cbm-instructions/micro-change/demo_script.md

## Einführung

Stellt euch vor ihr sitzt daheim vor dem Fernseher und seht wieder einmal Bilder von Müllinseln in den Meeren unserer schönen Erde.
Ihr sind bereit euren Beitrag zu leisten und möchtet bewusster und verantwortungsvoller mit eurem Müll umgehen, um genau solche Bilder zu verhindern.
Bei eurem nächsten Einkauf achtet ihr darauf weniger Plastikverpackungen zu kaufen, oder geht vielleicht sogar in einen Verpackungsfreiladen, doch ihr habt nach ein paar Tagen immer noch nicht so wirklich das Gefühl, dass sich etwas an eurem Müllverbrauch geändert hat. Woche für Woche tragt ihr euren Müll raus und fühlt euch machtlos bei dem Kampf um den Schutz unserer Erde.

"Wenn es doch nur eine Möglichkeit gäbe, wie ich meinen Einfluss auf die Umwelt wirklich wahrnehmen könnte!" :(

Sucht nicht länger, denn ihr habt ihn gefunden. Wir präsentieren euch "BEN", den smarten Kumpel für euer Zuhause.
"BEN" hilft euch ganz einfach nachzuvollziehen wie viel Müll ihr Tag für Tag produziert.

Mit seinem integrierten Gewichtssensor misst er wie viel Müll ihr produziert und stellt euch diese Messungen einfach und verständlich dar.
Auf dem hightech Touchdisplay könnt ihr zwischen unterschiedlichen Darstellungsvarianten wählen, um so einen perfekten Einblick in eure eigene Müllproduktion zu erlangen.

Und wenn ihr dachtet das war alles, dann haltet euch fest. Denn die innovativen Köpfe des Teams MicroChange, haben durch ihren modernen Gamefication-Ansatz eine noch größere Motivation für euch geschaffen, einen umweltbewussten Umgang mit eurem Müll zu haben.
BEN gibt euch Live-Feedback darüber, ob ihr euch in eurer Müllproduktion verbessert oder verschlechtert habt. Über eine Live-Auswertung eurer Statistik zeigt euch BEN euren aktuellen Fortschritt im Kampf um einen saubereren Planeten.

- Bilder von Müllinseln in Ozeanen
- Ihr wollt verantwortungsvoller mit eurem Müll umgehen
- Ihr habt selbst nach Wochen immer noch nicht das Gefühl, dass ihr euch verbessert
- Ihr fühlt euch machtlos im Kampf um den Schutz der Erde

"Wenn es doch nur eine Möglichkeit gäbe, wie ich meinen Einfluss auf die Umwelt wirklich wahrnehmen könnte!" :(

Sucht nicht länger, denn ihr habt ihn gefunden. Wir präsentieren euch "BEN", den smarten Kumpel für euer Zuhause.
"BEN" hilft euch ganz einfach nachzuvollziehen wie viel Müll ihr Tag für Tag produziert.

- Gewichtssensor misst eure Müllproduktion und zeigt sie euch einfach und verständlich
- Mit dem Touchdisplay könnt ihr einfach zwischen verschiedenen Ansichten wechseln

- Die innvativen Köpfe von Team MicroChange ...
- ... nutzen einen modernen Gamification-Ansatz um größere Motivation zu schafffen
- Live-Feedback über Verbesserung/Verschlechterung
-
