cbm-instructions/micro-change/bin-client/src/images/baumtoeter.png

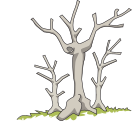
bin-client/src/images/baumtoeter.png
