cbm-instructions/micro-change/bin-client/src/images/house.png

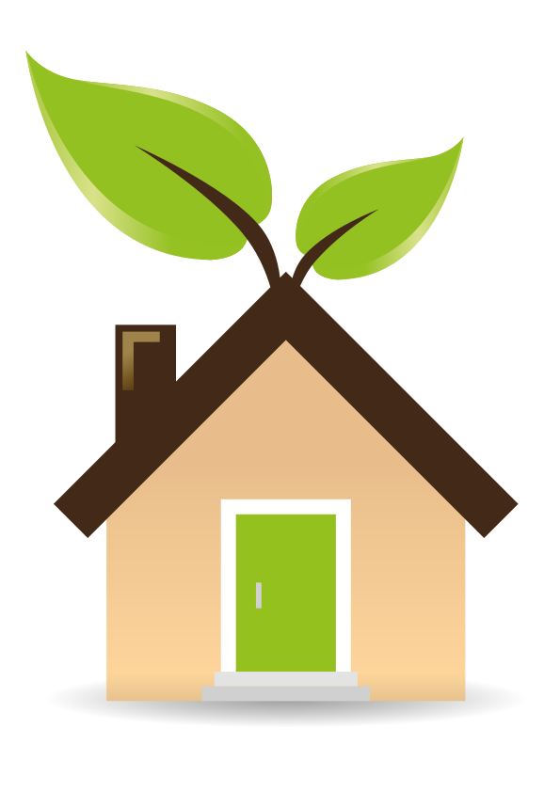
bin-client/src/images/house.png
