cbm-instructions/micro-change/bin-client/src/images/sad_face.png

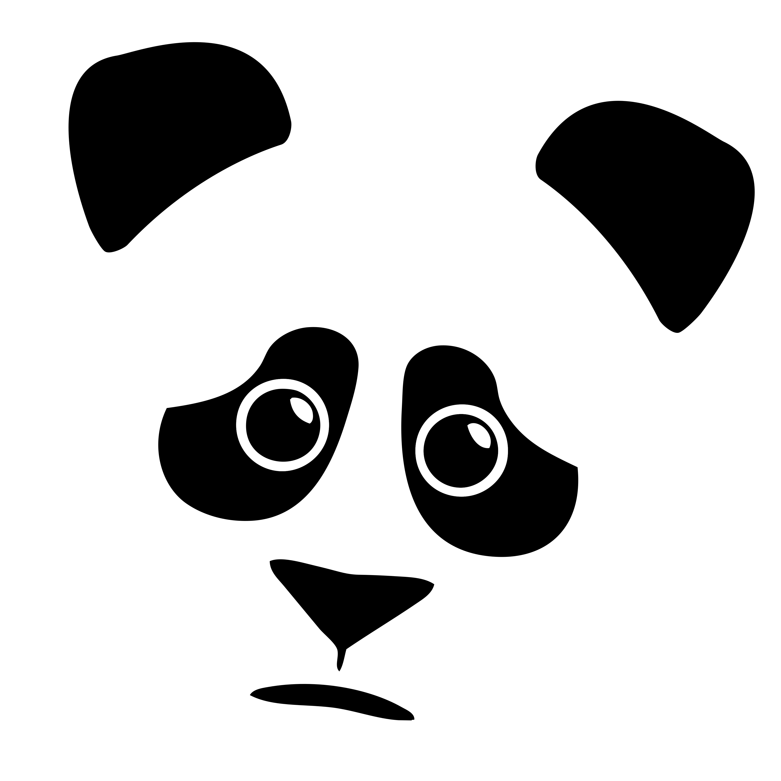
bin-client/src/images/sad_face.png
