cbm-instructions/micro-change/bin-client/src/images/start.png

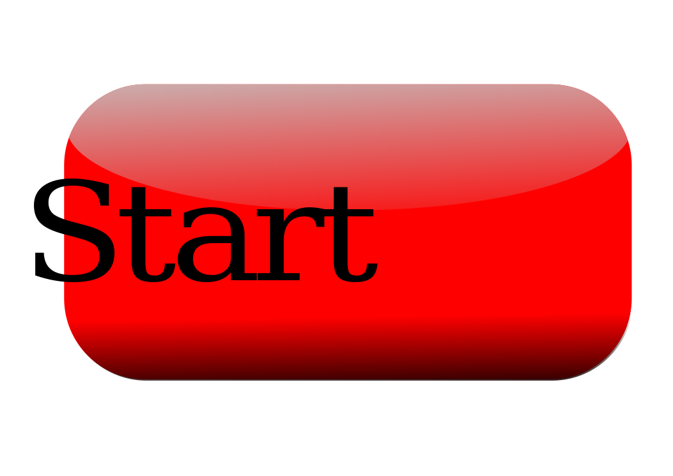
bin-client/src/images/start.png
