cbm-instructions/micro-change/bin-client/src/images/thumbs_up.png

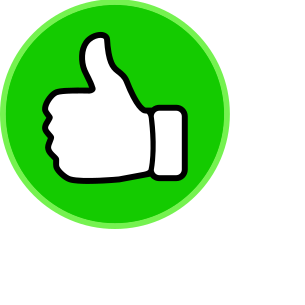
bin-client/src/images/thumbs_up.png
