cbm-instructions/micro-change/bin-client/src/images/vorbild.png

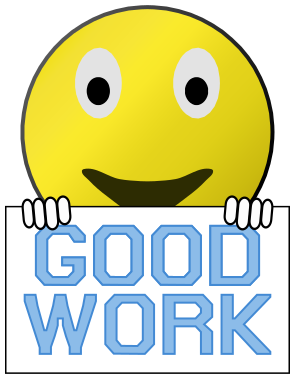
bin-client/src/images/vorbild.png
