cbm-instructions/micro-change/images/micro-change/arduino_geklebt.jpeg

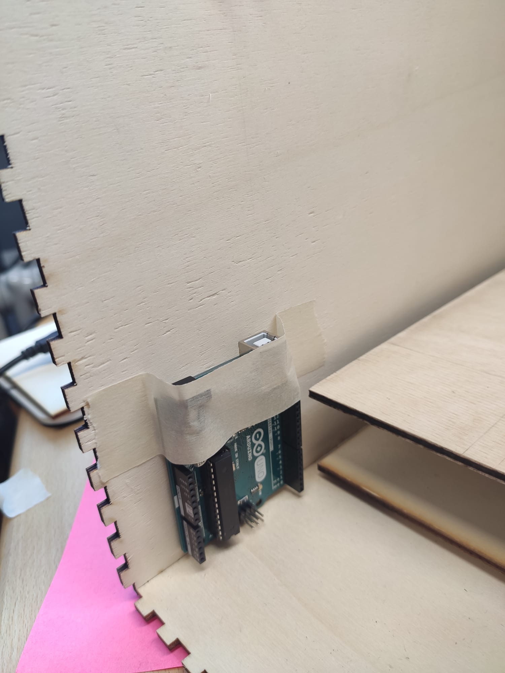
images/micro-change/arduino_geklebt.jpeg
