cbm-instructions/micro-change/images/micro-change/bodenplatte_seitlich.jpg

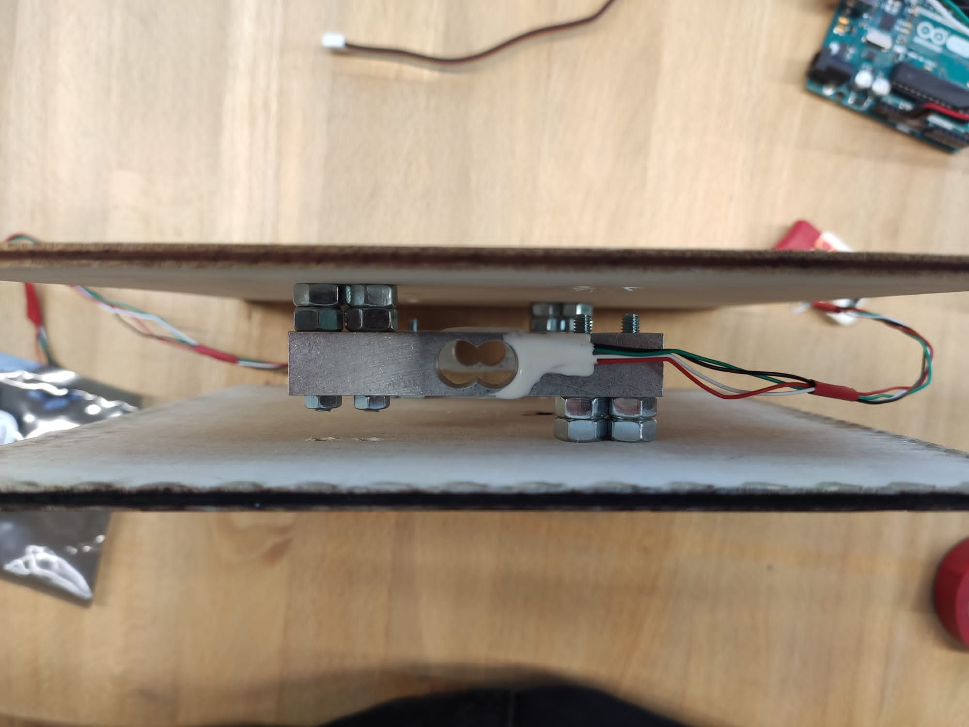
images/micro-change/bodenplatte_seitlich.jpg
