cbm-instructions/micro-change/images/micro-change/breadboard_geklebt.jpeg

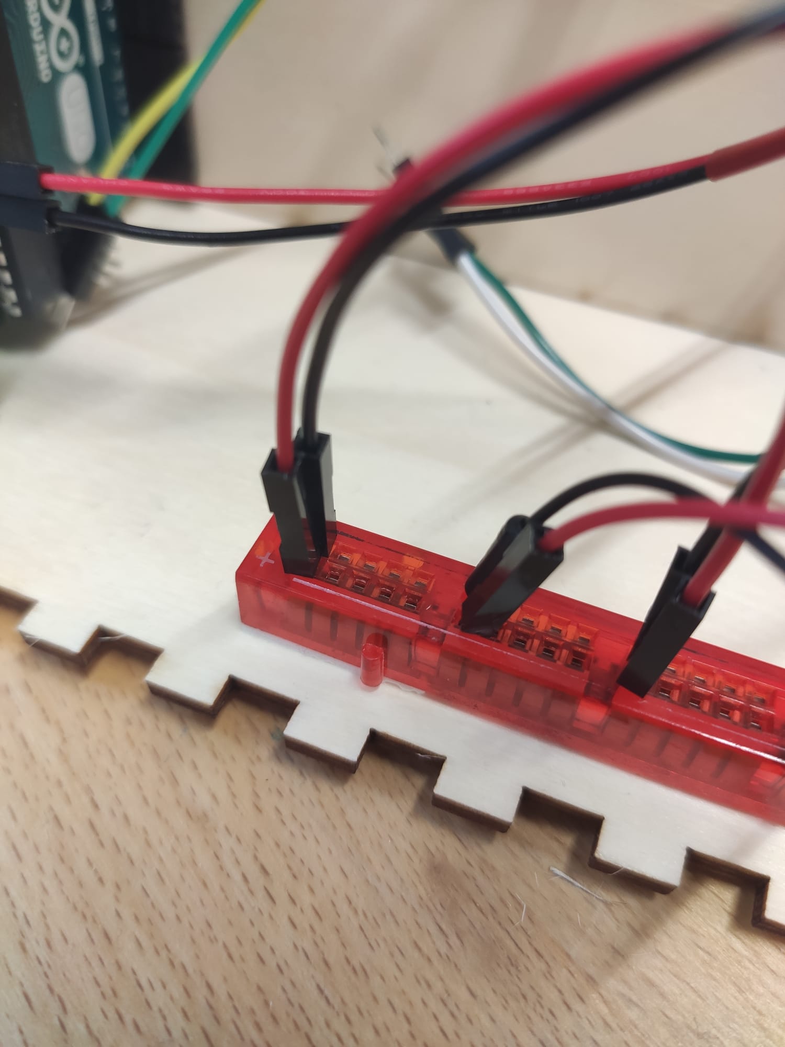
images/micro-change/breadboard_geklebt.jpeg
