cbm-instructions/micro-change/images/micro-change/hinten.jpeg

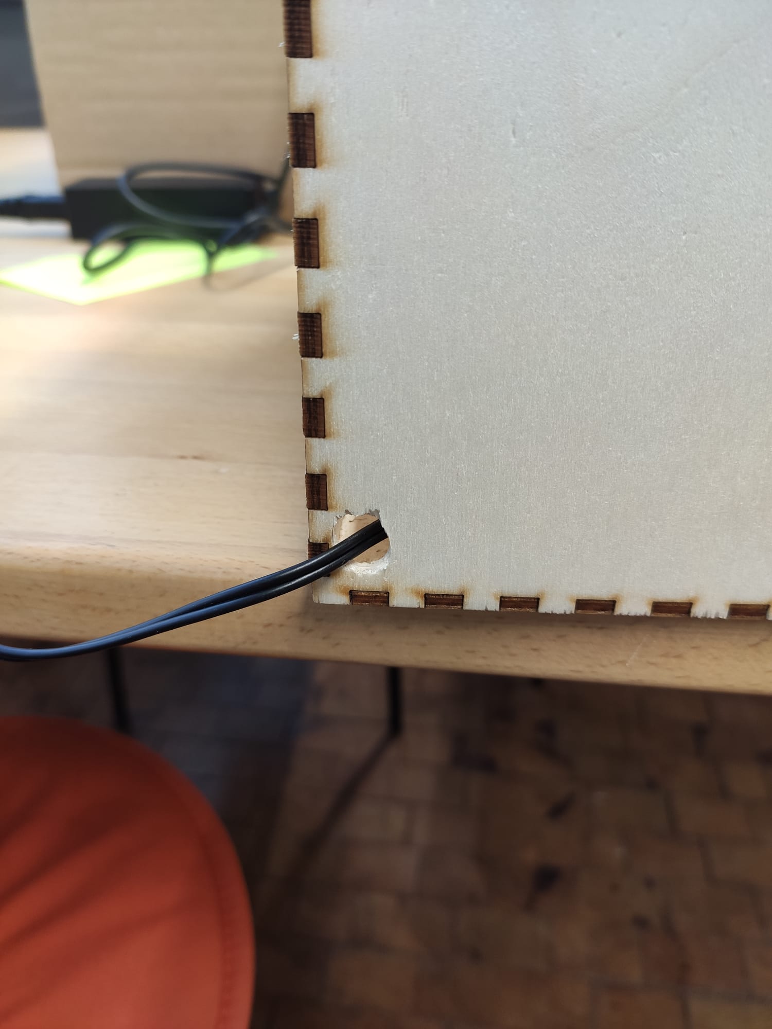
images/micro-change/hinten.jpeg
