cbm-instructions/micro-change/images/micro-change/mit_trennwand.jpeg

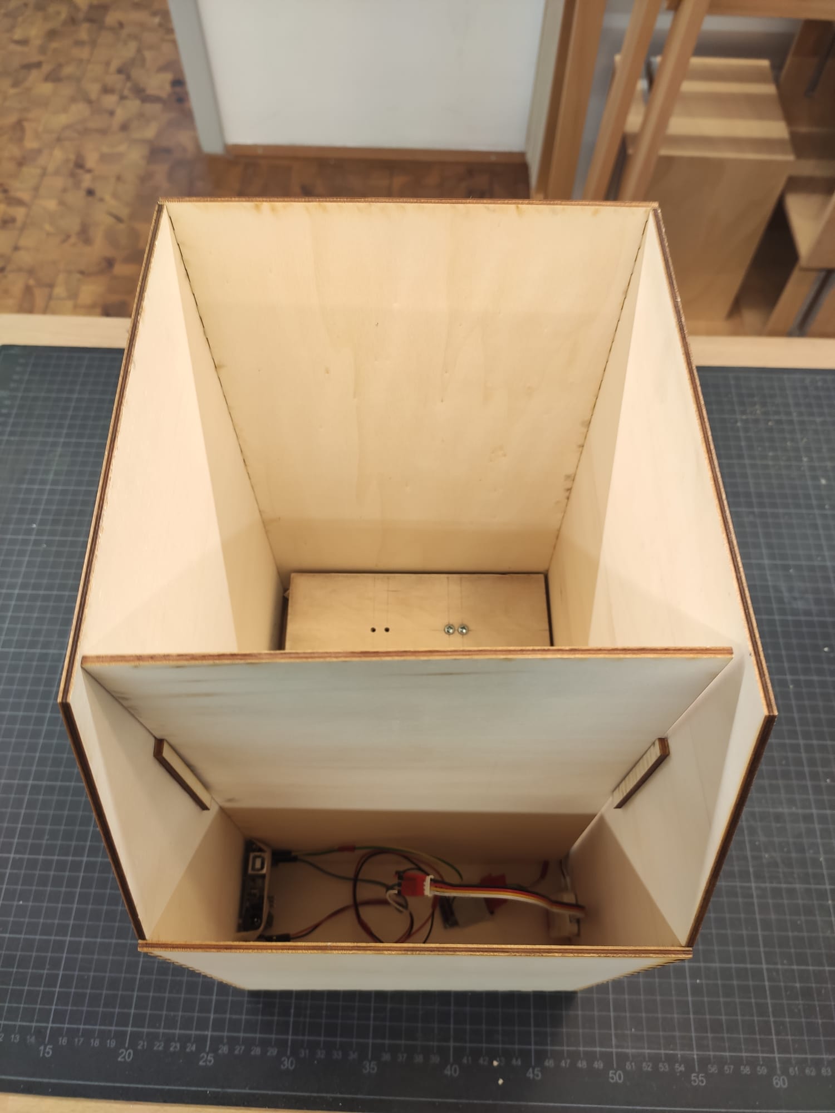
images/micro-change/mit_trennwand.jpeg
