cbm-instructions/micro-change/images/micro-change/oben_geschlossen.jpeg

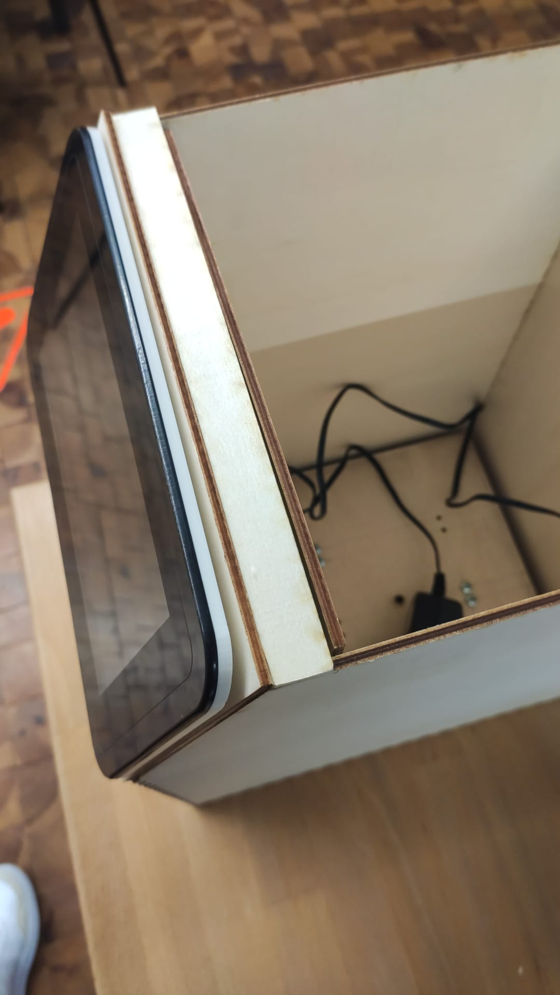
images/micro-change/oben_geschlossen.jpeg
