cbm-instructions/micro-change/images/micro-change/ohne_schnittstelle.jpeg

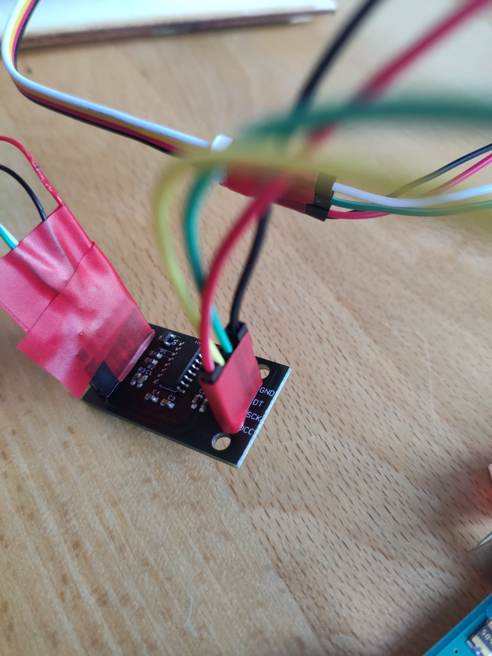
images/micro-change/ohne_schnittstelle.jpeg
