cbm-instructions/micro-change/images/micro-change/schnittstelle.jpeg

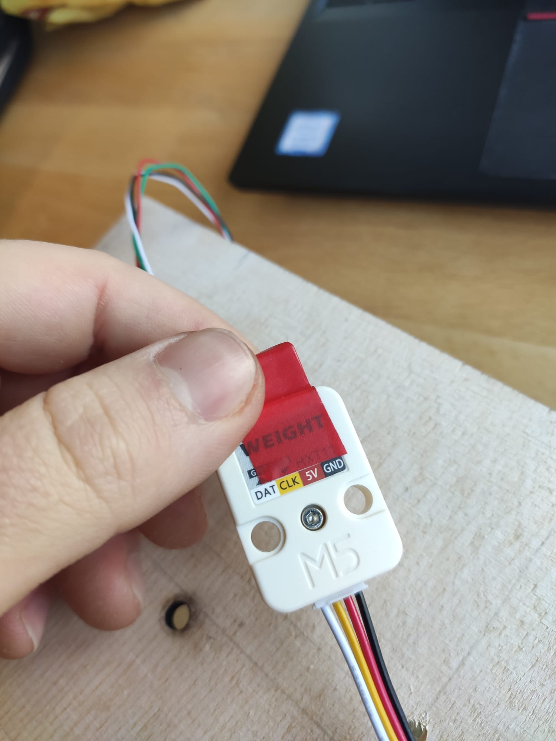
images/micro-change/schnittstelle.jpeg
