cbm-instructions/micro-change/images/micro-change/schräg_vorn.jpeg

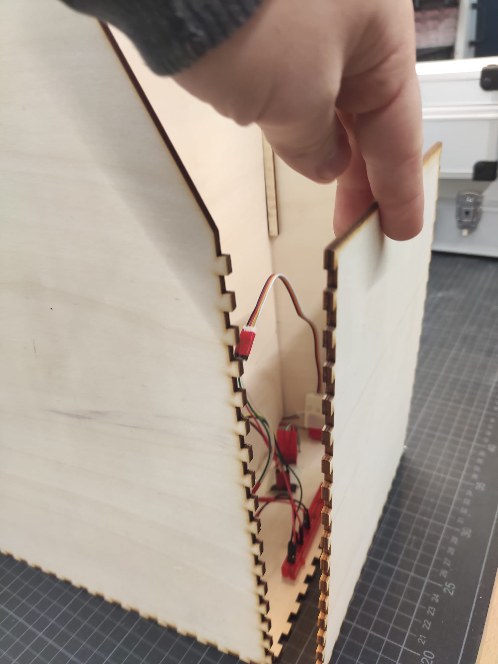
images/micro-change/schräg_vorn.jpeg
