cbm-instructions/micro-change/images/micro-change/unten.jpeg

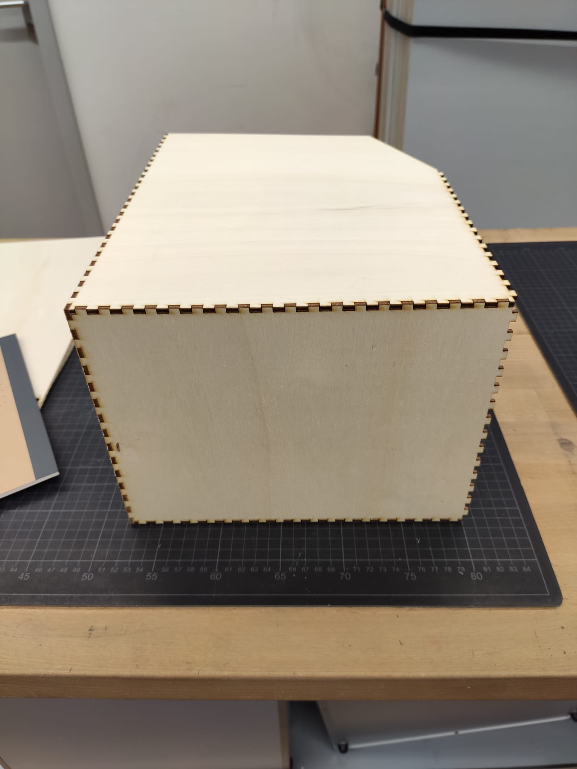
images/micro-change/unten.jpeg
