cbm-instructions/micro-change/images/micro-change/vorn.jpeg

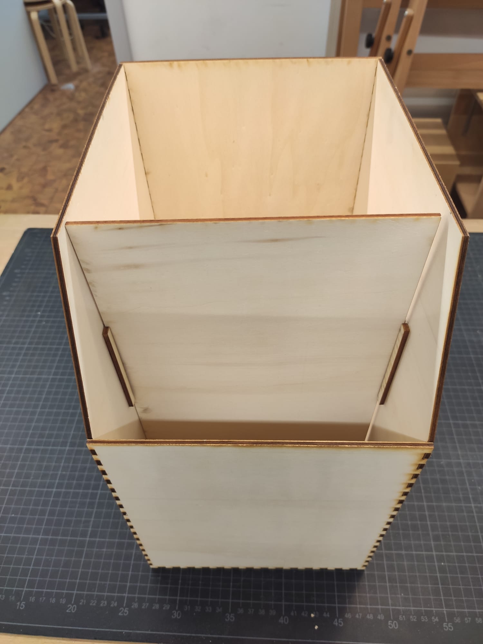
images/micro-change/vorn.jpeg
