cbm-instructions/micro-change/images/micro-change/vorn_mit_bodenplatte.jpeg

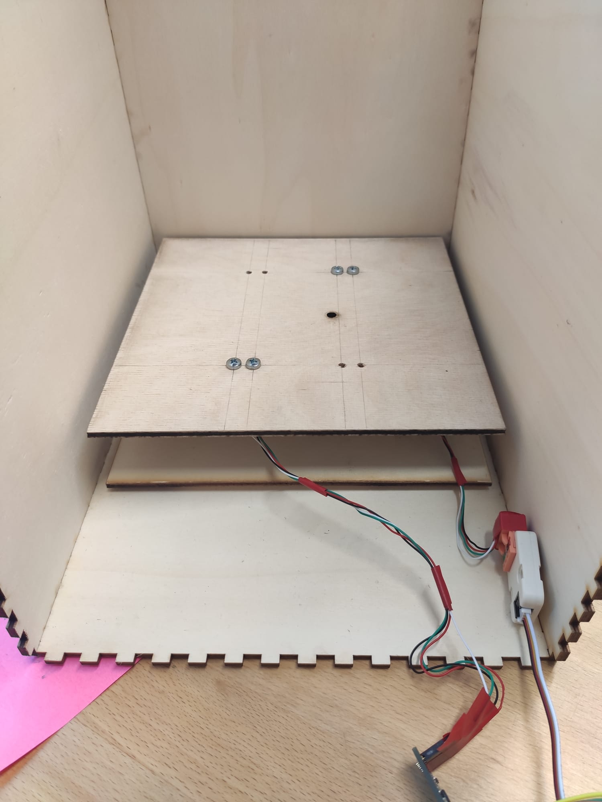
images/micro-change/vorn_mit_bodenplatte.jpeg
