cbm-instructions/micro-change/images/micro-change/vorn_mit_trennwand.jpeg

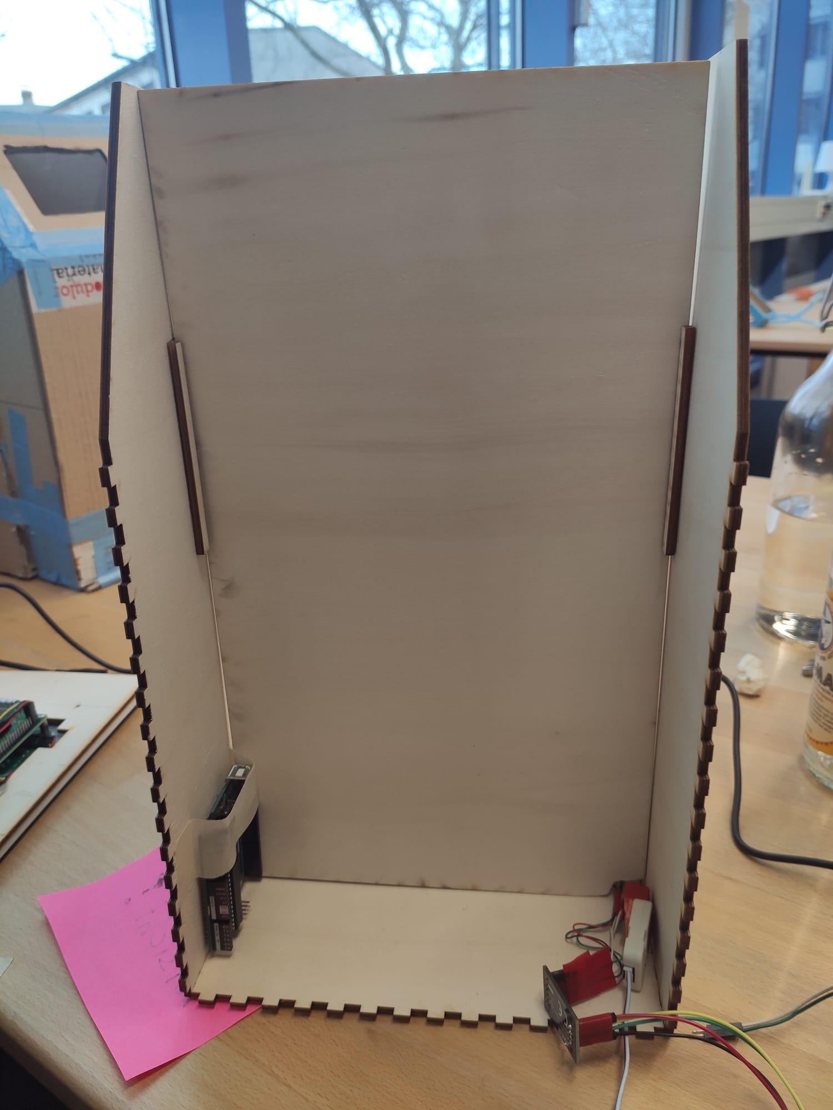
images/micro-change/vorn_mit_trennwand.jpeg
