cbm-instructions/micro-change/images/micro-change/waegzelle_einbau.jpg

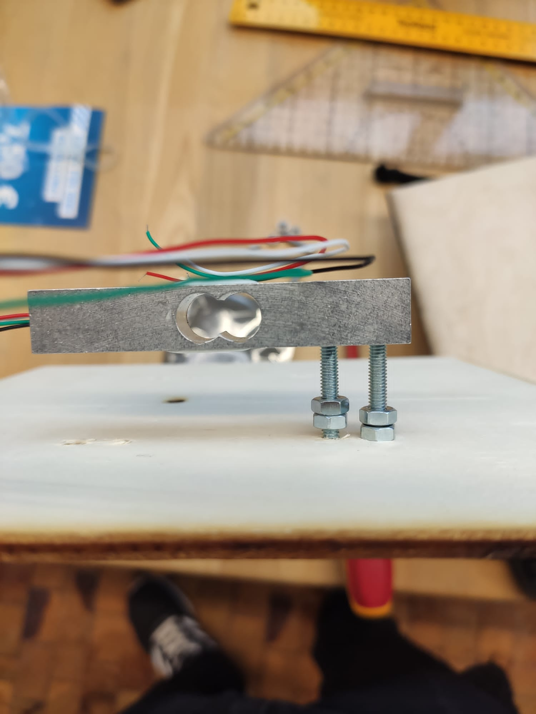
images/micro-change/waegzelle_einbau.jpg
