cbm-instructions/micro-change/lasercutter_files/zwischenstand_muelleimer.jpg

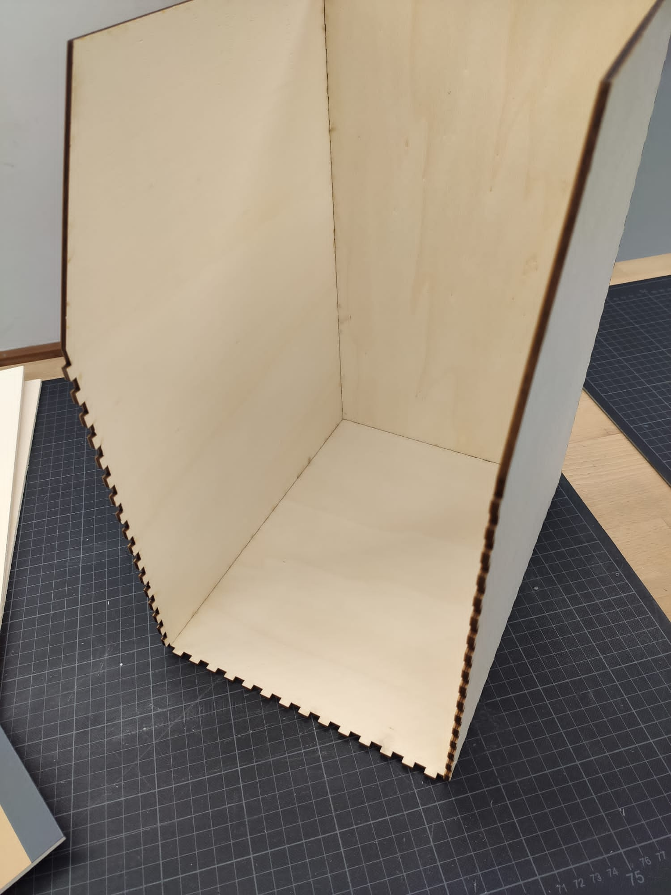
lasercutter_files/zwischenstand_muelleimer.jpg
