cbm-instructions/micro-change/(commit log)

2021-12-09 added arduino project
2021-12-28 added arduino project for calibrated scale; added calibration factors as txt file
2021-12-28 added core functionality to record data from arduino scale
2021-12-29 fixed read of DEBUG envvar
    [recorder.py]
2021-12-29 added lasercutter files for bin/trashcan
2022-01-02 added sample data for scale
2022-01-02 changed sample folder
2022-01-04 added tabs to switch between table and chart; added achievement component and test button for it
2022-01-09 added sample data
2022-01-13 sample folder added
2022-01-27 fixed bug that first start of recorder.py throws an error on parsing to utf-8 string
    [recorder.py]
